RNO-G/rnog_vpol_fat_dipole/README.md

# rnog_vpol_fat_dipole
Simulations of the vertically polarized antenna used in the RNO-G experiment
