RNO-G/rnog_vpol_fat_dipole/simulations/vpol_xfdtd_simulation.xf/ProjectImage.png

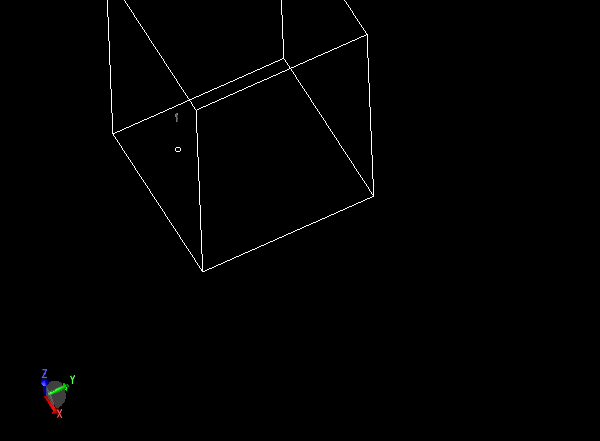
simulations/vpol_xfdtd_simulation.xf/ProjectImage.png
