RNO-G/rnog_vpol_fat_dipole/cad_files/step_files/full_assembly.STEP

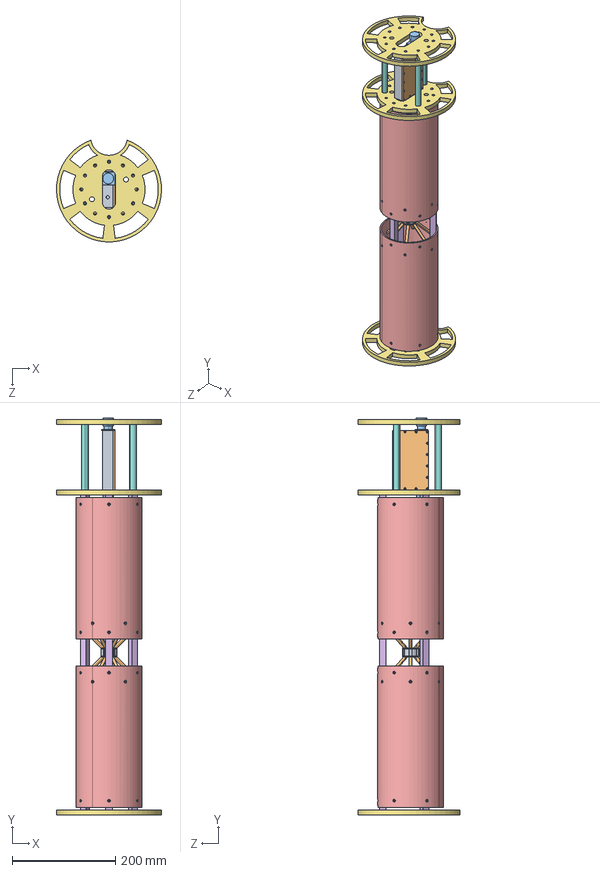
[picture p2: CAD file, 2021-06-22]
cad_files/step_files/full_assembly.STEP
203.2 x 768.0 x 196.8 mm
spacer
spoke x 12
hub_top
hub_bottom
sym_body x 2
long_support x 3
hub_support x 3
short_support x 3
inice_bottom
inice_top
fake_sma_with_cable x 2
