RNO-G/rnog_vpol_fat_dipole/cad_files/dxf_files/hub_top_drawing.DXF

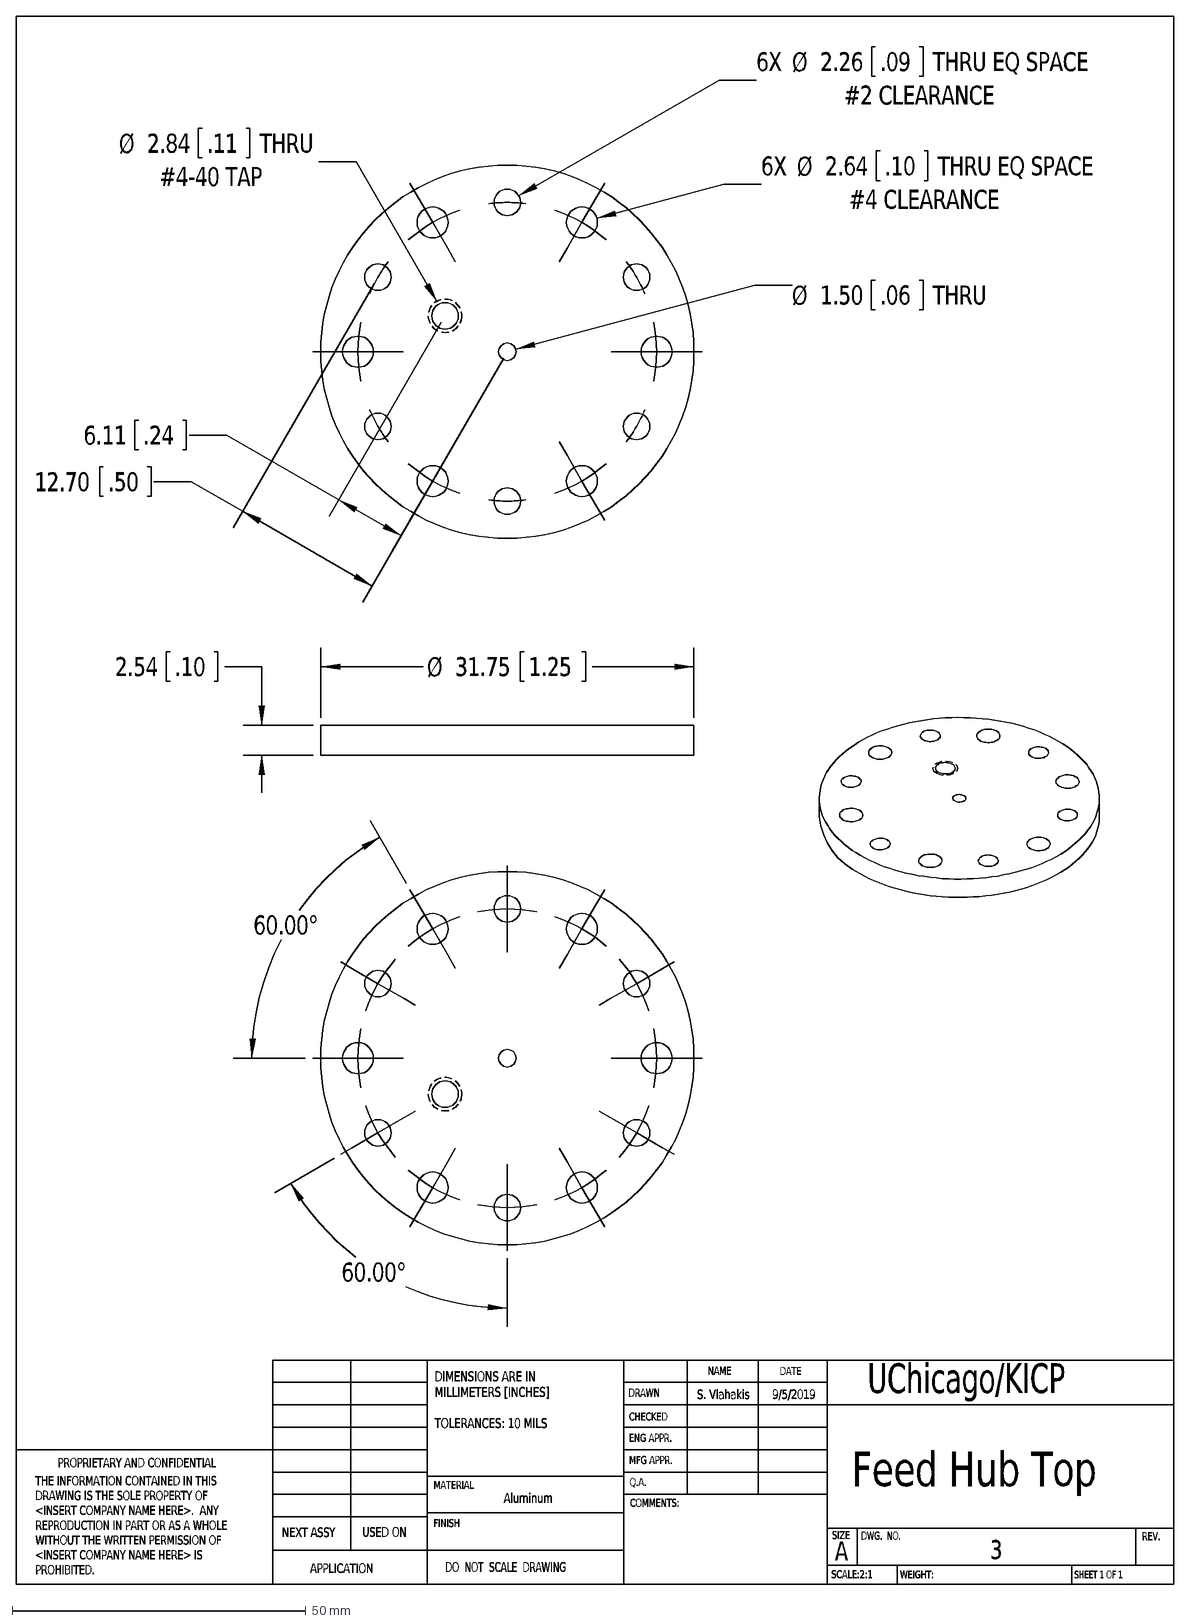
[picture p3: CAD file, 2021-06-22]
cad_files/dxf_files/hub_top_drawing.DXF
WEIGHT:
3
Aluminum
S. Vlahakis
9/5/2019
PROPRIETARY AND CONFIDENTIAL
THE INFORMATION CONTAINED IN THIS
DRAWING IS THE SOLE PROPERTY OF
<INSERT COMPANY NAME HERE>. ANY
REPRODUCTION IN PART OR AS A WHOLE
WITHOUT THE WRITTEN PERMISSION OF
<INSERT COMPANY NAME HERE> IS
PROHIBITED.
COMMENTS:
SHEET 1 OF 1
Q.A.
MFG APPR.
ENG APPR.
CHECKED
DRAWN
DATE
NAME
DIMENSIONS ARE IN
MILLIMETERS [INCHES]
TOLERANCES: 10 MILS
NEXT ASSY
USED ON
APPLICATION
DO NOT SCALE DRAWING
FINISH
MATERIAL
REV.
A
DWG. NO.
SIZE
SCALE:2:1
Feed Hub Top
UChicago/KICP
6X
Ø
2.26
.09
THRU EQ SPACE
#2 CLEARANCE
2.64
.10
#4 CLEARANCE
2.84
.11
THRU
#4-40 TAP
1.50
.06
6.11
.24
12.70
.50
31.75
1.25
2.54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
