RNO-G/rnog_vpol_fat_dipole/cad_files/hub_support_rev2.SLDPRT

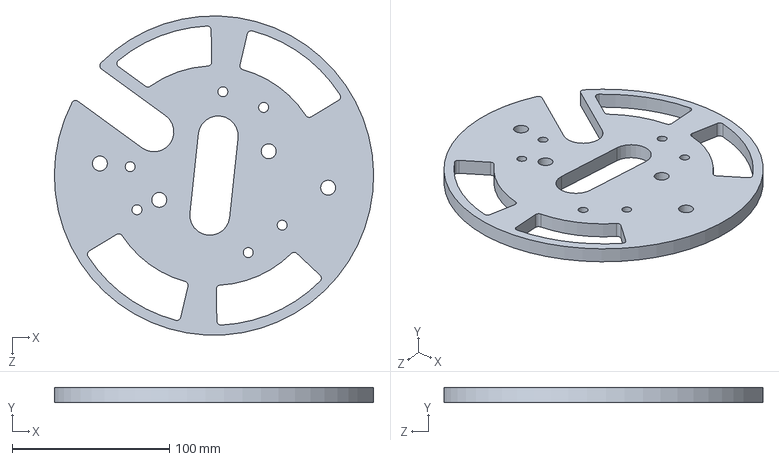
[picture p4: CAD file, 2021-06-21]
cad_files/hub_support_rev2.SLDPRT
203.2 x 9.53 x 203.0 mm
