RNO-G/rnog_vpol_fat_dipole/cad_files/step_files/hub_bottom.STEP

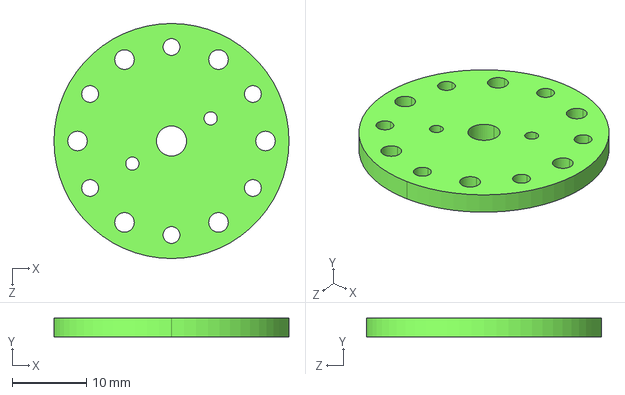
[picture p5: CAD file, 2021-06-22]
cad_files/step_files/hub_bottom.STEP
31.8 x 2.54 x 31.8 mm
