RNO-G/rnog_vpol_fat_dipole/cad_files/dxf_files/hub_bottom_drawing.DXF

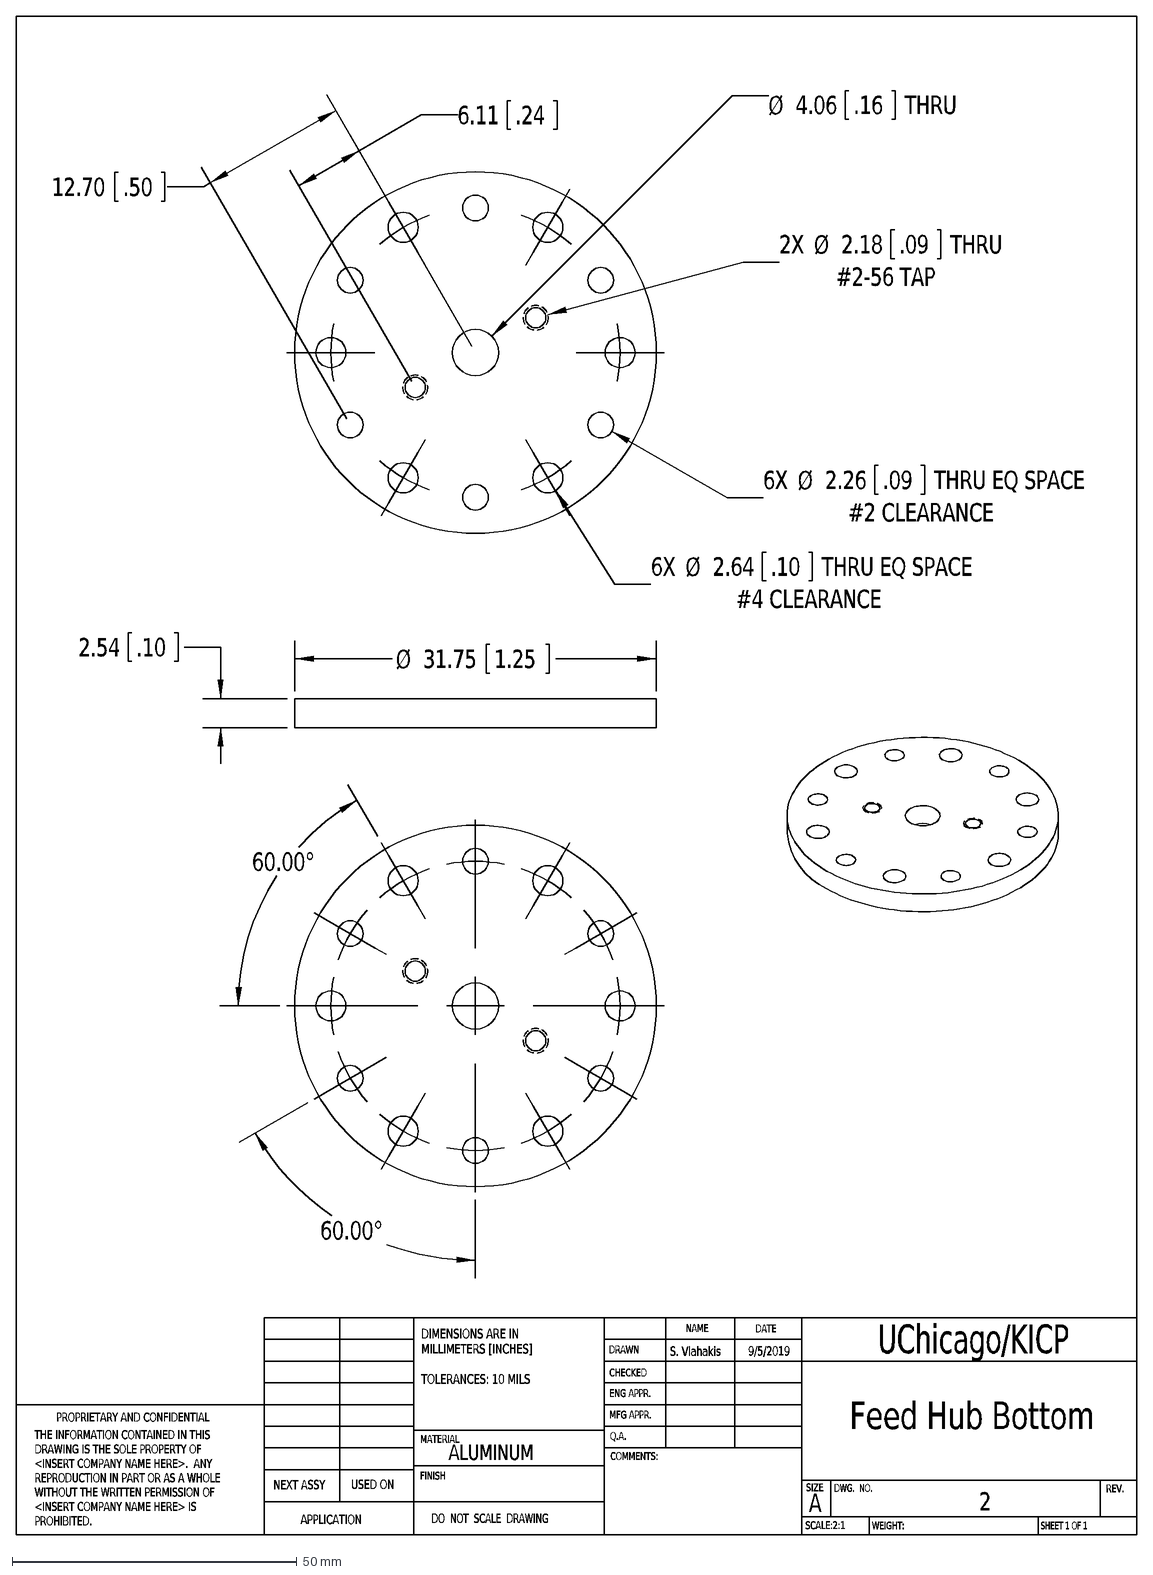
[picture p6: CAD file, 2021-06-22]
cad_files/dxf_files/hub_bottom_drawing.DXF
WEIGHT:
2
UChicago/KICP
9/5/2019
Feed Hub Bottom
PROPRIETARY AND CONFIDENTIAL
THE INFORMATION CONTAINED IN THIS
DRAWING IS THE SOLE PROPERTY OF
<INSERT COMPANY NAME HERE>. ANY
REPRODUCTION IN PART OR AS A WHOLE
WITHOUT THE WRITTEN PERMISSION OF
<INSERT COMPANY NAME HERE> IS
PROHIBITED.
COMMENTS:
SHEET 1 OF 1
Q.A.
MFG APPR.
ENG APPR.
CHECKED
DRAWN
DATE
NAME
DIMENSIONS ARE IN
MILLIMETERS [INCHES]
TOLERANCES: 10 MILS
NEXT ASSY
USED ON
APPLICATION
DO NOT SCALE DRAWING
FINISH
MATERIAL
REV.
A
DWG. NO.
SIZE
SCALE:2:1
ALUMINUM
S. Vlahakis
2X
Ø
2.18
.09
THRU
#2-56 TAP
4.06
.16
6X
2.26
THRU EQ SPACE
#2 CLEARANCE
2.64
.10
#4 CLEARANCE
6.11
.24
12.70
.50
31.75
1.25
2.54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
