RNO-G/rnog_vpol_fat_dipole/cad_files/short_support.SLDPRT

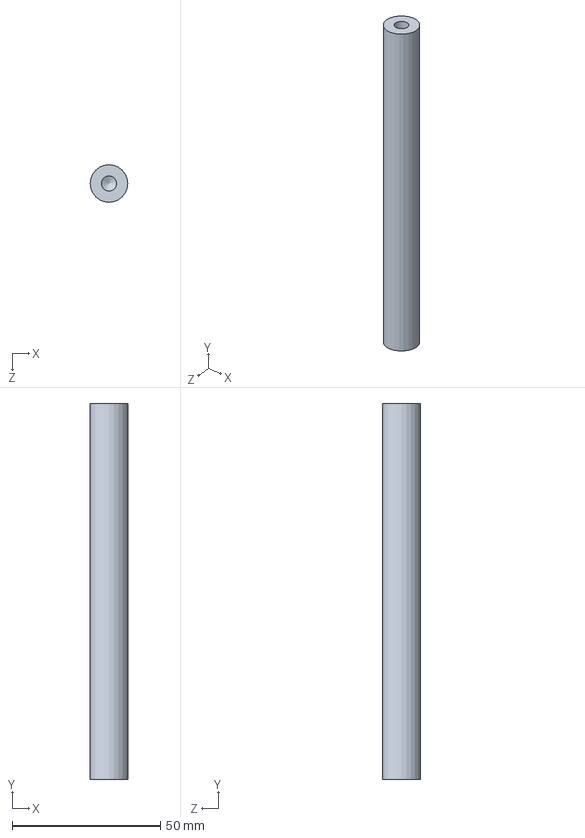
[picture p7: CAD file, 2021-06-21]
cad_files/short_support.SLDPRT
12.7 x 127.0 x 12.7 mm
