RNO-G/rnog_vpol_fat_dipole/cad_files/step_files/spacer.STEP

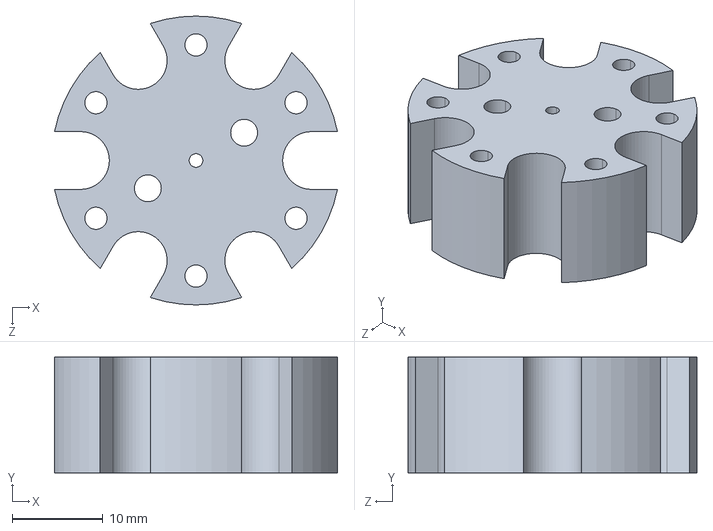
[picture p8: CAD file, 2021-06-22]
cad_files/step_files/spacer.STEP
31.1 x 12.7 x 31.8 mm
