RNO-G/rnog_vpol_fat_dipole/cad_files/step_files/sym_body.STEP

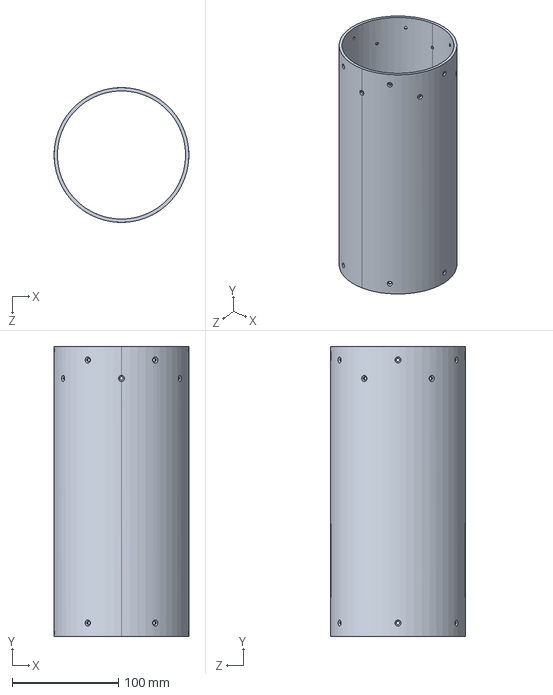
[picture p9: CAD file, 2021-06-22]
cad_files/step_files/sym_body.STEP
127.0 x 273.1 x 127.0 mm
