RNO-G/rnog_vpol_fat_dipole/cad_files/step_files/spoke.STEP

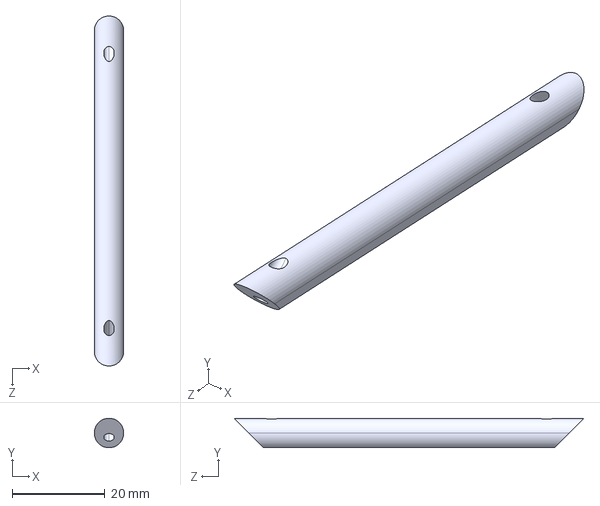
[picture p10: CAD file, 2021-06-22]
cad_files/step_files/spoke.STEP
6.35 x 6.35 x 75.4 mm
