RNO-G/rnog_vpol_fat_dipole/cad_files/step_files/hub_support.STEP

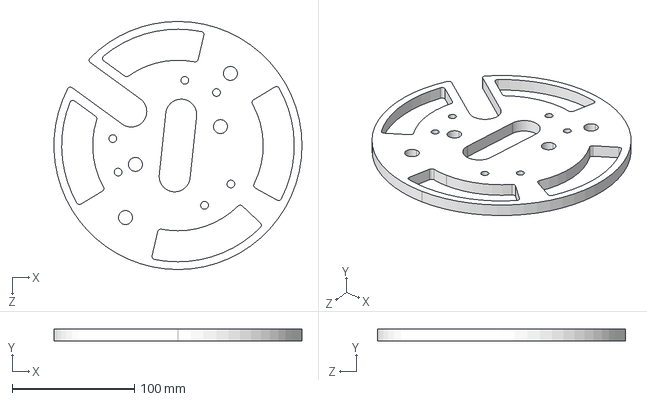
[picture p11: CAD file, 2021-06-22]
cad_files/step_files/hub_support.STEP
203.1 x 9.53 x 203.2 mm
