RNO-G/rnog_vpol_fat_dipole/cad_files/step_files/long_support.STEP

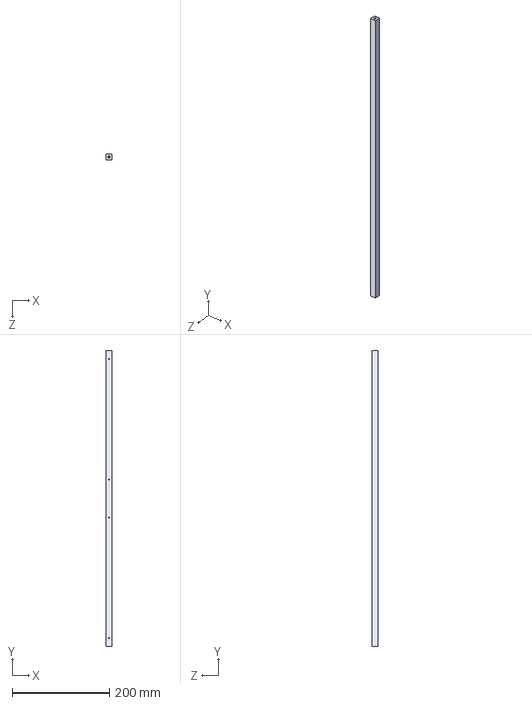
[picture p12: CAD file, 2021-06-22]
cad_files/step_files/long_support.STEP
12.7 x 609.6 x 12.7 mm
