RNO-G/rnog_vpol_fat_dipole/(list of files, cad)

Other CAD files:
cad_files/step_files/hub_top.STEP
cad_files/dxf_files/full_assembly.DXF
cad_files/dxf_files/hub_support.DXF
cad_files/dxf_files/long_support.DXF
cad_files/dxf_files/spacer.DXF
cad_files/dxf_files/spoke.DXF
cad_files/dxf_files/sym_body.DXF
cad_files/full_assembly.SLDASM
cad_files/full_assembly.SLDDRW
cad_files/hub_bottom.SLDPRT
cad_files/hub_support.SLDDRW
cad_files/hub_support.SLDPRT
cad_files/hub_top.SLDPRT
cad_files/long_support.SLDDRW
cad_files/long_support.SLDPRT
cad_files/spacer.SLDDRW
cad_files/spacer.SLDPRT
cad_files/spoke.SLDDRW
cad_files/spoke.SLDPRT
cad_files/sym_body.SLDDRW
cad_files/sym_body.SLDPRT
