RNO-G/rnog_vpol_fat_dipole/cad_files/pdf_files/full_assembly.pdf

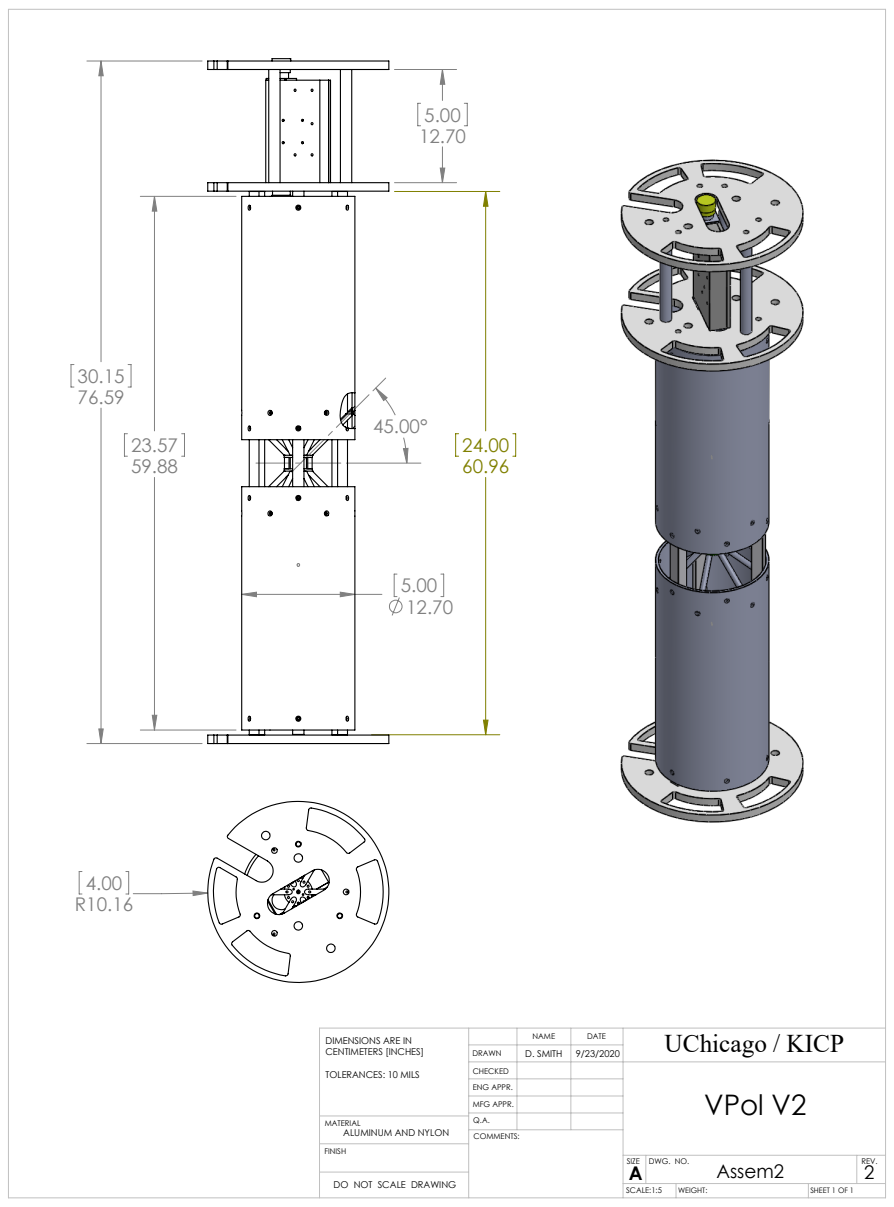
[picture p13: page 1]

CENTIMETERS [INCHES] TOLERANCES: 10 MILS | | D. SMITH NAME | 9/23/2020 DATE DIMENSIONS ARE IN | UChicago / KICP

DRAWN
CHECKED
ENG APPR.
MFG APPR. | | | VPol V2 COMMENTS:

MATERIAL ALUMINUM AND NYLON | Q.A.

SIZE A | DWG. NO. Assem2 | REV. 2

DO NOT SCALE DRAWING

SCALE:1:5 | WEIGHT: | SHEET 1 OF 1
