RNO-G/rnog_vpol_fat_dipole/cad_files/pdf_files/hub_bottom_drawing.PDF

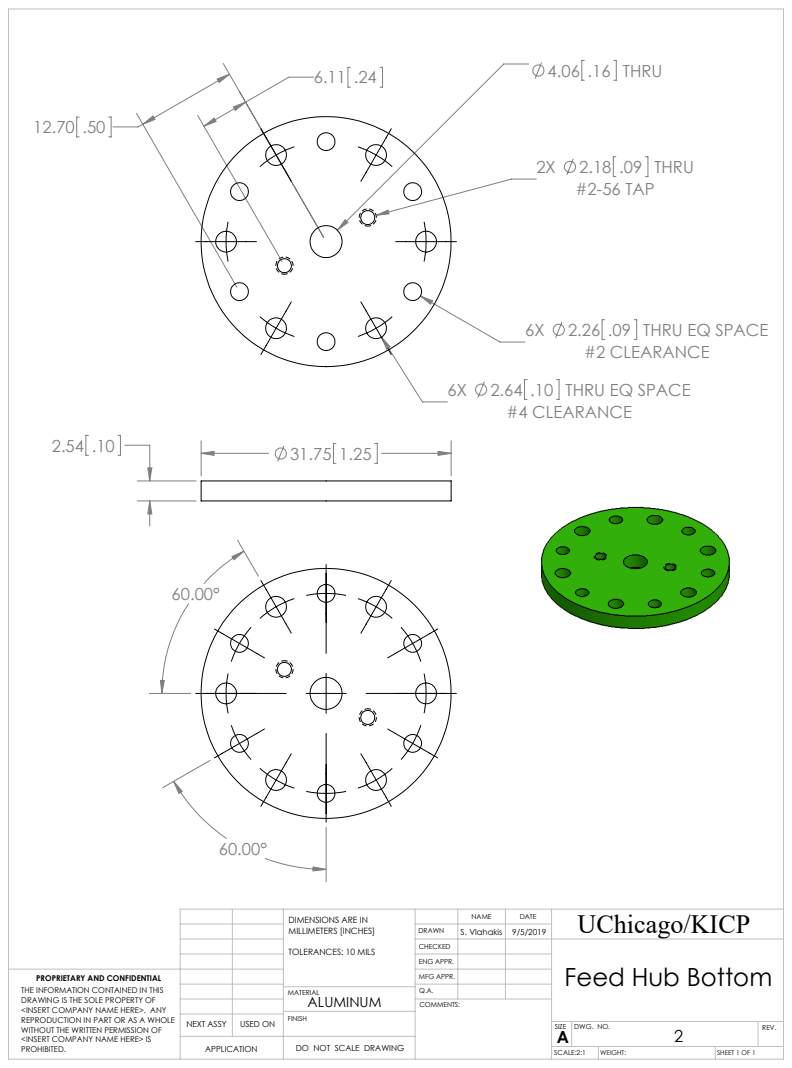
[picture p14: page 1]
2X 2.18 .09 THRU #2-56 TAP; 4.06 .16 THRU

6X 2.26 .09 THRU EQ SPACE
#2 CLEARANCE

6X 2.64 .10 THRU EQ SPACE
#4 CLEARANCE

MILLIMETERS [INCHES] TOLERANCES: 10 MILS | | NAME | 9/5/2019 DATE DIMENSIONS ARE IN | UChicago/KICP Feed Hub Bottom DRAWING IS THE SOLE PROPERTY OF

DRAWN | S. Vlahakis
CHECKED
ENG APPR.

PROPRIETARY AND CONFIDENTIAL THE INFORMATION CONTAINED IN THIS <INSERT COMPANY NAME HERE>. ANY REPRODUCTION IN PART OR AS A WHOLE WITHOUT THE WRITTEN PERMISSION OF <INSERT COMPANY NAME HERE> IS PROHIBITED. | | | MFG APPR.

MATERIAL ALUMINUM | Q.A.

NEXT ASSY | USED ON | FINISH

SIZE A | DWG. NO. 2 | REV.

APPLICATION | | DO NOT SCALE DRAWING

SCALE:2:1 | WEIGHT: | SHEET 1 OF 1
