RNO-G/rnog_vpol_fat_dipole/cad_files/pdf_files/hub_top_drawing.PDF

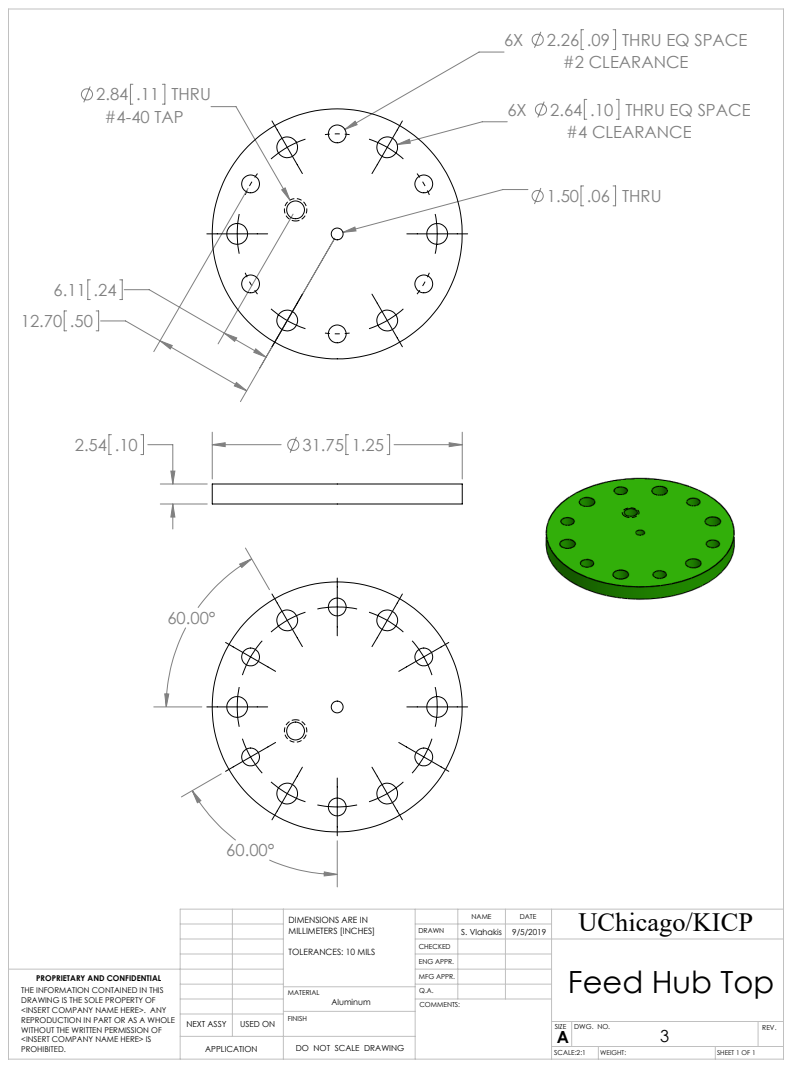
[picture p15: page 1]
2.84 .11 THRU #4-40 TAP; 1.50 .06 THRU

6X 2.26 .09 THRU EQ SPACE
#2 CLEARANCE

6X 2.64 .10 THRU EQ SPACE
#4 CLEARANCE

MILLIMETERS [INCHES] TOLERANCES: 10 MILS | | NAME | DATE DIMENSIONS ARE IN | UChicago/KICP

DRAWN | S. Vlahakis | 9/5/2019
CHECKED | | | Feed Hub Top
ENG APPR.

PROPRIETARY AND CONFIDENTIAL THE INFORMATION CONTAINED IN THIS DRAWING IS THE SOLE PROPERTY OF <INSERT COMPANY NAME HERE>. ANY REPRODUCTION IN PART OR AS A WHOLE WITHOUT THE WRITTEN PERMISSION OF <INSERT COMPANY NAME HERE> IS PROHIBITED. | | | MFG APPR.

MATERIAL Aluminum | Q.A.

NEXT ASSY | USED ON | FINISH

SIZE A | DWG. NO. 3 | REV.

APPLICATION | | DO NOT SCALE DRAWING

SCALE:2:1 | WEIGHT: | SHEET 1 OF 1
