RNO-G/rnog_vpol_fat_dipole/cad_files/pdf_files/spacer.PDF

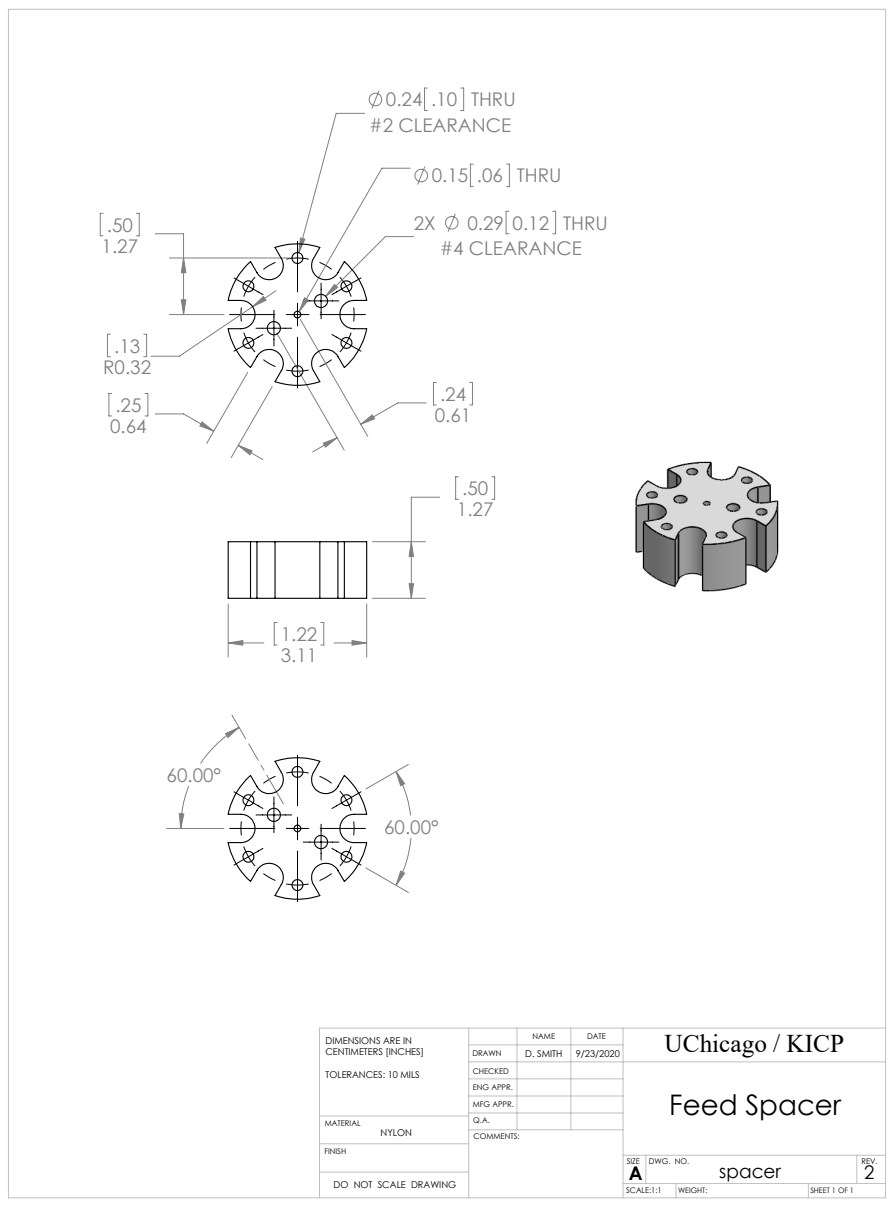
[picture p16: page 1]
0.24 .10 THRU #2 CLEARANCE; 0.15 .06 THRU; 0.29 0.12 THRU; #4 CLEARANCE

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

DRAWN
CHECKED
ENG APPR.
MFG APPR. | | | Feed Spacer COMMENTS:

MATERIAL NYLON | Q.A.

SIZE A | DWG. NO. spacer | REV. 2

DO NOT SCALE DRAWING

SCALE:1:1 | WEIGHT: | SHEET 1 OF 1
