RNO-G/rnog_vpol_fat_dipole/cad_files/pdf_files/sym_body.PDF

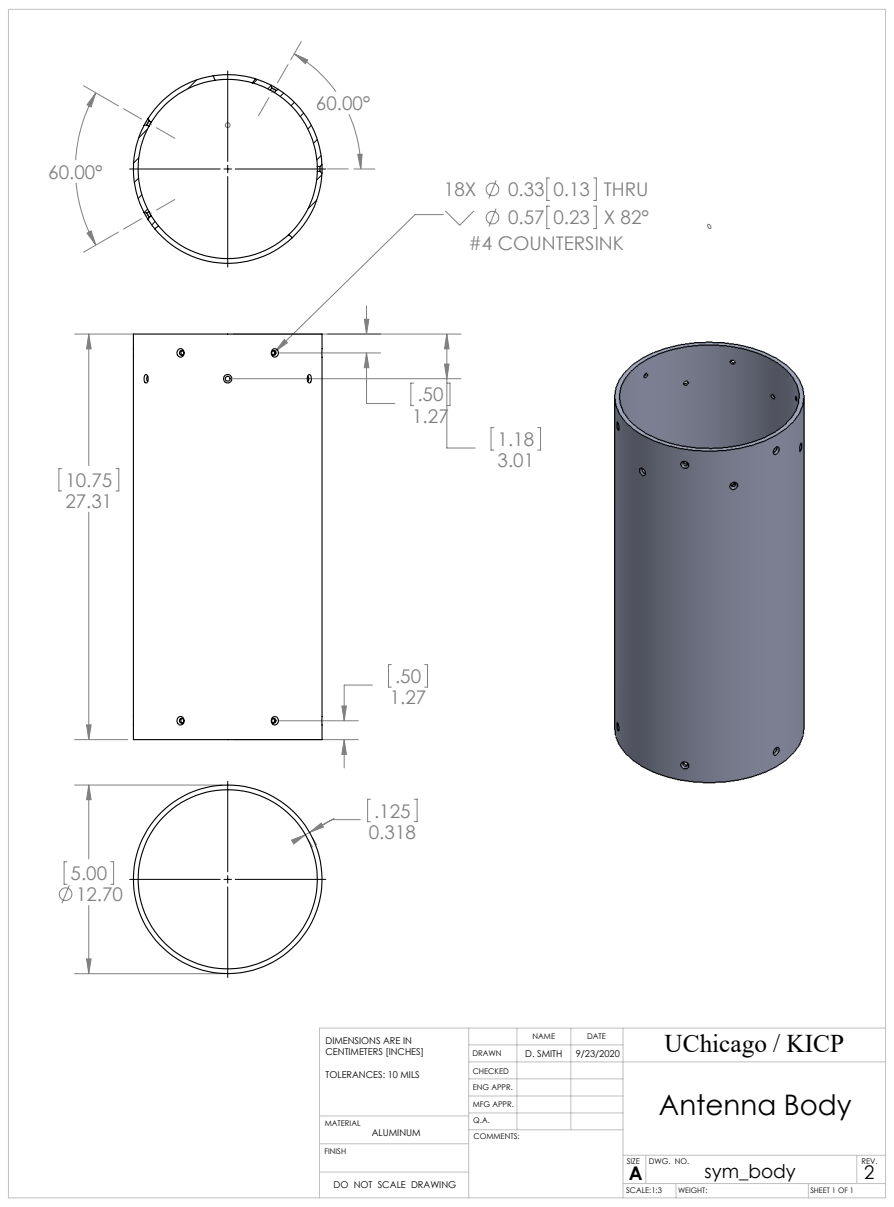
[picture p17: page 1]
0.33 0.13 THRU; 0.57 0.23 X 82° #4 COUNTERSINK

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

DRAWN
CHECKED
ENG APPR.
MFG APPR. | | | Antenna Body COMMENTS:

MATERIAL ALUMINUM | Q.A.

SIZE A | DWG. NO. sym_body | REV. 2

DO NOT SCALE DRAWING

SCALE:1:3 | WEIGHT: | SHEET 1 OF 1
