RNO-G/rnog_vpol_fat_dipole/simulations/plots/vpol_v2_realized_gain_freq_domain.pdf

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

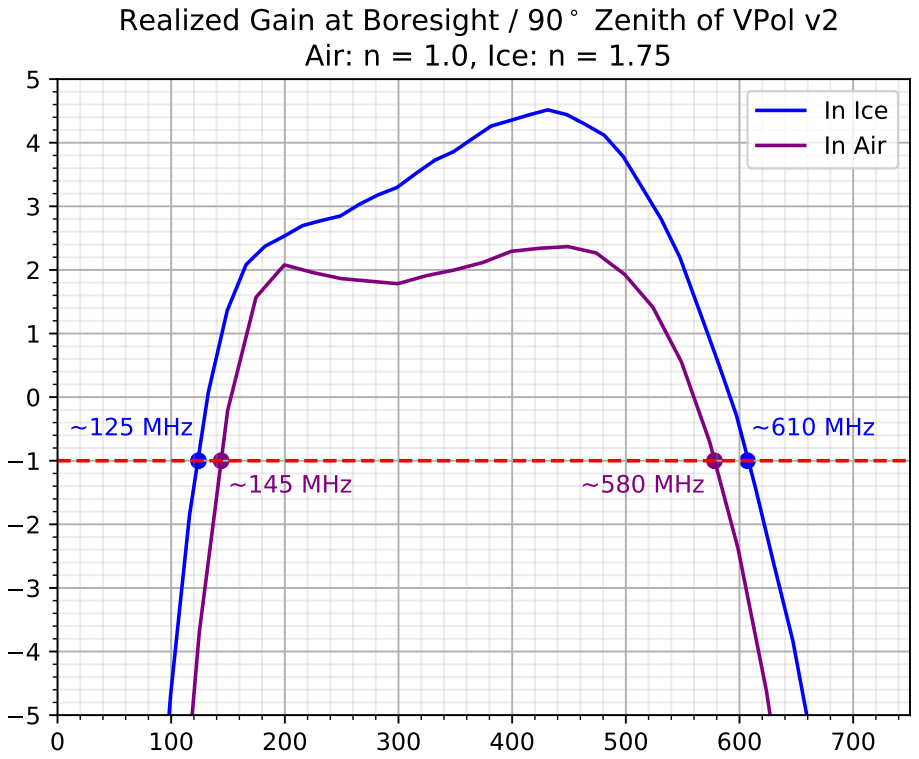
[picture p19: page 1]
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
