RNO-G/rnog_vpol_fat_dipole/cad_files/pdf_files/hub_support.PDF

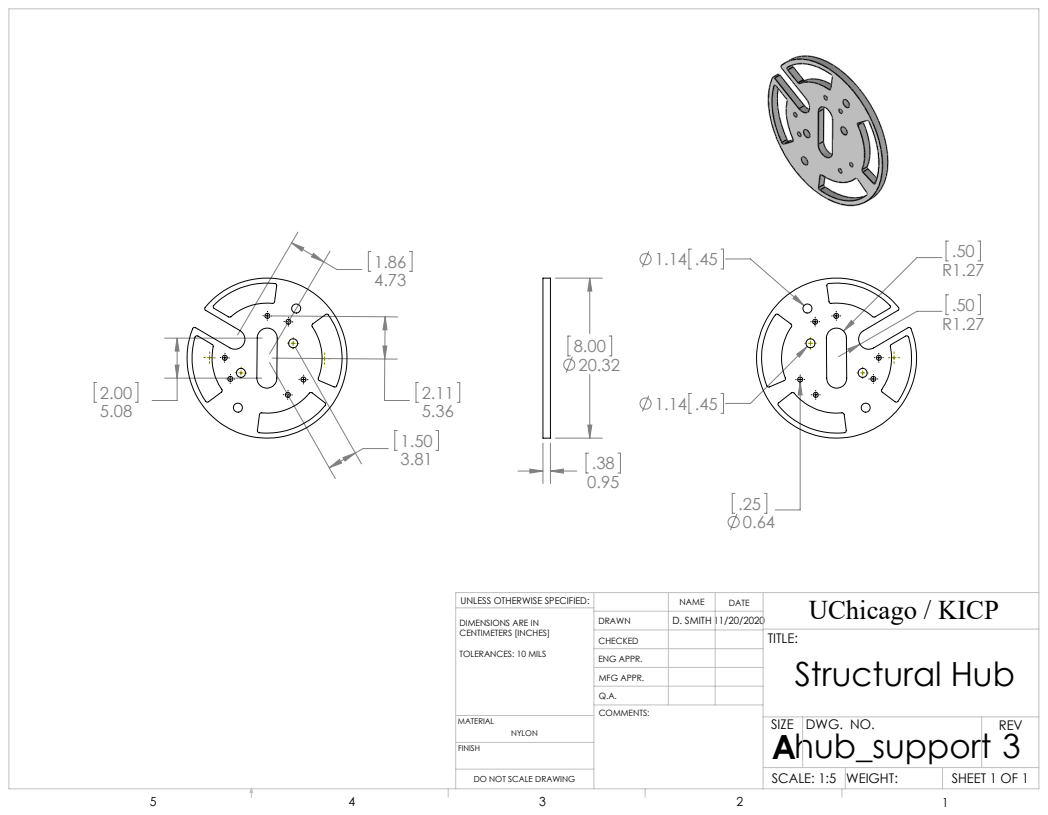
[picture p21: page 1]
Structural Hub; SHEET 1 OF 1; D. SMITH 11/20/2020; SCALE: 1:5 WEIGHT:; DWG. NO.; REV; UChicago / KICP NAME; DATE; MFG APPR.; ENG APPR.

UNLESS OTHERWISE SPECIFIED:

DIMENSIONS ARE IN
CENTIMETERS [INCHES]
TOLERANCES: 10 MILS

DO NOT SCALE DRAWING
