RNO-G/rnog_vpol_fat_dipole/cad_files/pdf_files/long_support.PDF

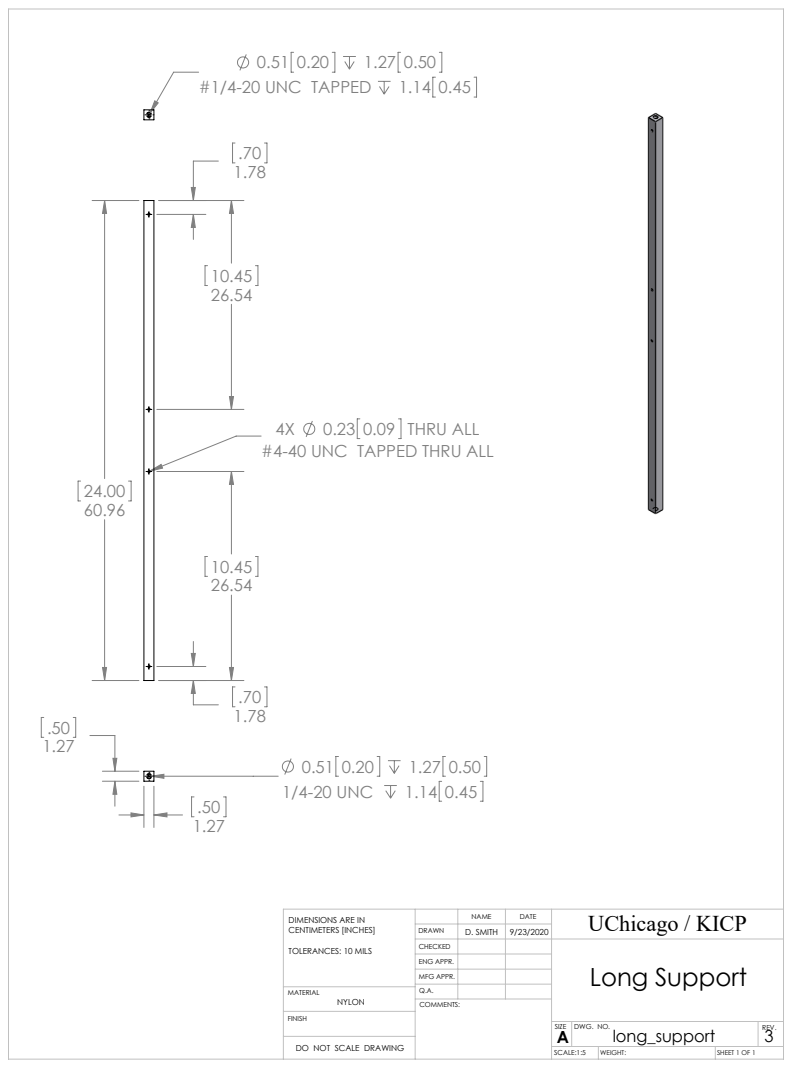
[picture p22: page 1]
0.23 0.09 THRU ALL; #1/4-20 UNC TAPPED 1.14 0.45; 1/4-20 UNC

#4-40 UNC TAPPED THRU ALL

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

DRAWN
CHECKED
ENG APPR.
MFG APPR. | | | Long Support COMMENTS:

MATERIAL NYLON | Q.A.

SIZE A | DWG. NO. long_support | REV. 3

DO NOT SCALE DRAWING

SCALE:1:5 | WEIGHT: | SHEET 1 OF 1
