RNO-G/rnog_vpol_fat_dipole/cad_files/pdf_files/spoke.PDF

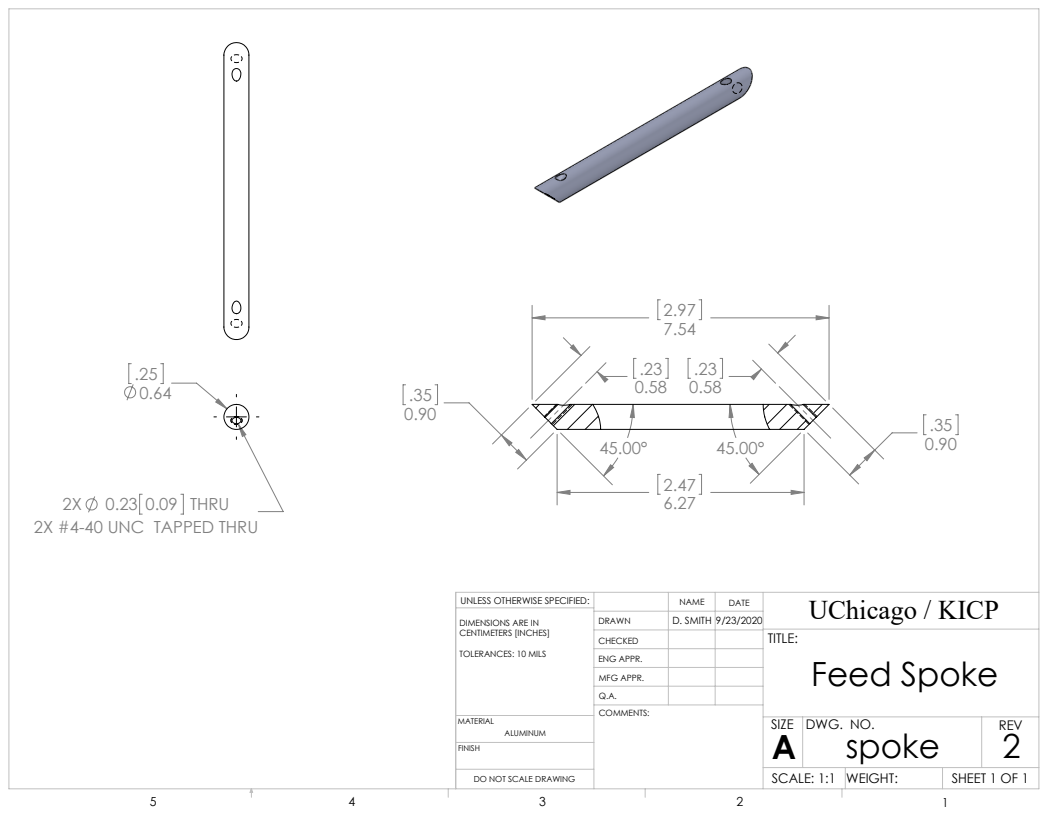
[picture p23: page 1]
Feed Spoke; SHEET 1 OF 1; D. SMITH 9/23/2020; SCALE: 1:1 WEIGHT:; DWG. NO.; REV; UChicago / KICP NAME; DATE; MFG APPR.; ENG APPR.

2X 0.23 0.09 THRU
2X #4-40 UNC TAPPED THRU

UNLESS OTHERWISE SPECIFIED:

DIMENSIONS ARE IN
CENTIMETERS [INCHES]
TOLERANCES: 10 MILS

DO NOT SCALE DRAWING
