RNO-G/rnog_vpol_fat_dipole/(commit log)

2021-06-21 Adding CAD files
    [Assem2.SLDASM, Assem2.SLDDRW, hub_bottom.SLDPRT, hub_support.SLDDRW, hub_support.SLDPRT, hub_support_rev2.SLDPRT, hub_top.SLDPRT, long_support.SLDDRW]
2021-06-22 CAD files in other formats
    [full_assembly.DXF, full_assembly.SLDASM, full_assembly.SLDDRW, full_assembly.STEP, hub_bottom.STEP, hub_bottom_drawing.DXF, hub_support.DXF, hub_support.STEP]
